KubaTaba1uga/open_source_ebook_reader/README.md

# open_source_ebook_reader
Open source ebook reader device.
