KubaTaba1uga/open_source_ebook_reader/docs/hardware.md

Hardware
===========

The ebook reader is composed of:
- [Display](hardware/display.md)
- [Buttons](hardware/buttons.md)
