KubaTaba1uga/open_source_ebook_reader/package/ebook_reader/data/poweroff_screen.png

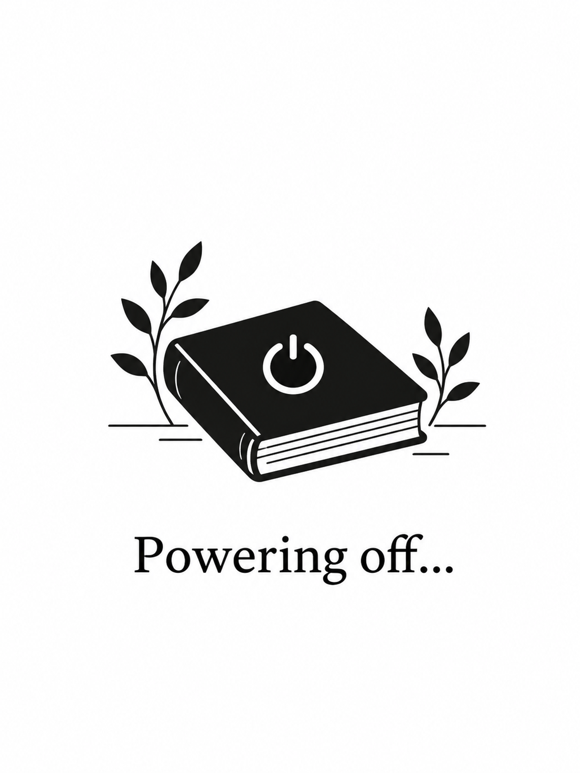
package/ebook_reader/data/poweroff_screen.png
