KubaTaba1uga/open_source_ebook_reader/kicad/rpi_hat/rpi_hat/rpi_hat.kicad_pcb

## KiCad design kicad/rpi_hat/rpi_hat/rpi_hat.kicad_pcb (2026-10-03)

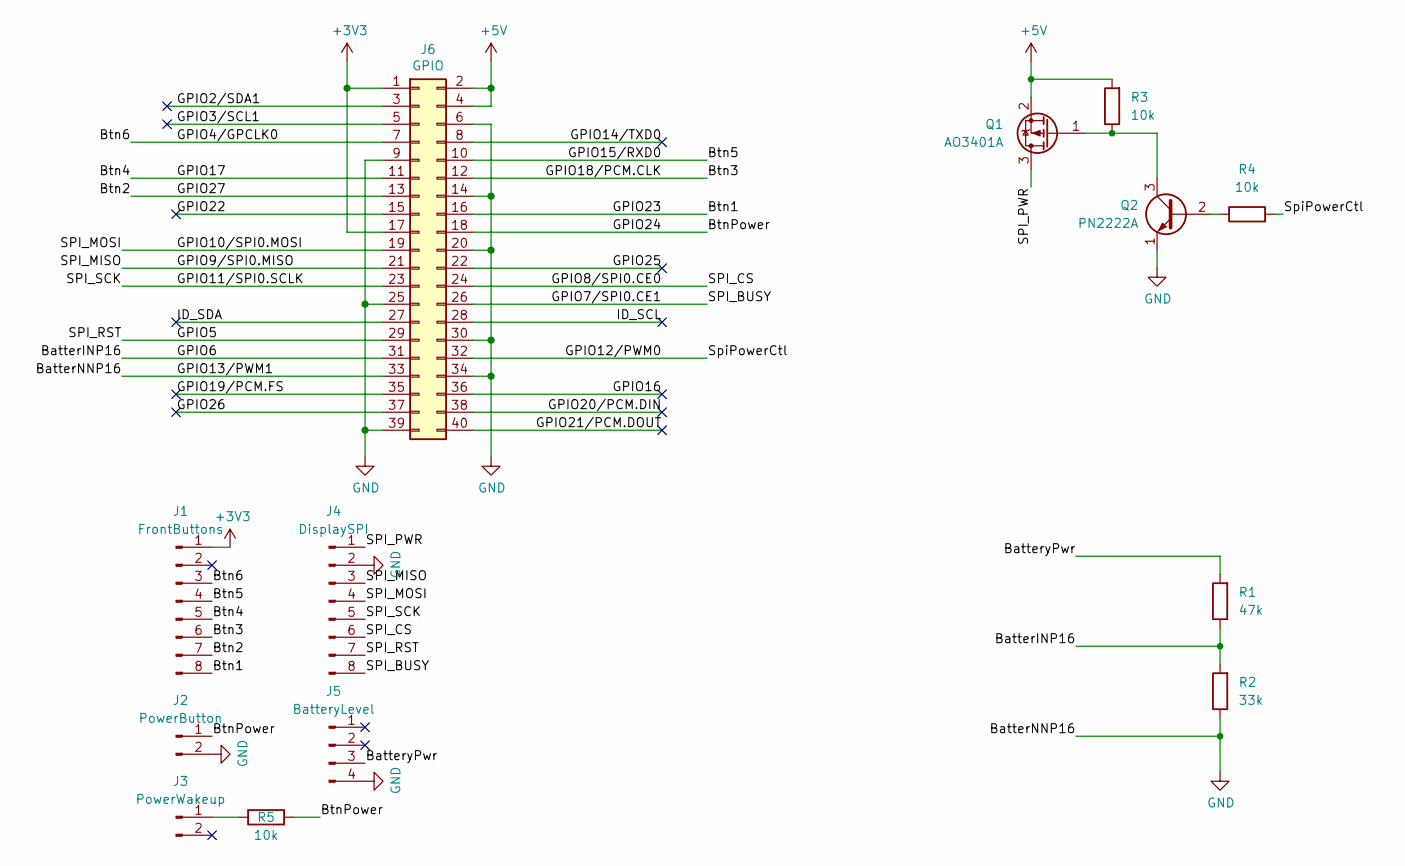
[picture p2: schematic rpi_hat.kicad_sch]

Parts:
J1: FrontButtons; JST_XH_S8B-XH-A_1x08_P2.50mm_Horizontal
J2: PowerButton; JST_XH_S2B-XH-A_1x02_P2.50mm_Horizontal
J3: PowerWakeup; JST_XH_S2B-XH-A_1x02_P2.50mm_Horizontal
J4: DisplaySPI; JST_PH_S8B-PH-K_1x08_P2.00mm_Horizontal
J5: BatteryLevel; JST_XH_S4B-XH-A_1x04_P2.50mm_Horizontal
J6: GPIO; PinSocket_2x20_P2.54mm_Vertical
Q1: AO3401A; SOT-23
Q2: PN2222A; TO-92_Inline
R1: 47k; R_Axial_DIN0207_L6.3mm_D2.5mm_P10.16mm_Horizontal
R2: 33k; R_Axial_DIN0207_L6.3mm_D2.5mm_P10.16mm_Horizontal
R3, R4, R5: 10k; R_Axial_DIN0207_L6.3mm_D2.5mm_P10.16mm_Horizontal

Connections:
+3V3: J1.1, J6.1, J6.17
+5V: J6.2, J6.4, Q1.2 (S), R3.2
/BatterINP16: J6.31, R1.1, R2.2
/BatteryPwr: J5.3, R1.2
/Btn1: J1.8, J6.16
/Btn2: J1.7, J6.13
/Btn3: J1.6, J6.12
/Btn4: J1.5, J6.11
/Btn5: J1.4, J6.10
/Btn6: J1.3, J6.7
/BtnPower: J2.1, J6.18, R5.2
/GPIO2/SDA1: J6.3
/GPIO3/SCL1: J6.5
/GPIO5: J4.7, J6.29
/GPIO7/SPI0.CE1: J4.8, J6.26
/GPIO8/SPI0.CE0: J4.6, J6.24
/GPIO9/SPI0.MISO: J4.3, J6.21
/GPIO10/SPI0.MOSI: J4.4, J6.19
/GPIO11/SPI0.SCLK: J4.5, J6.23
/GPIO12/PWM0: J6.32, R4.2
/GPIO14/TXD0: J6.8
/GPIO16: J6.36
/GPIO19/PCM.FS: J6.35
/GPIO20/PCM.DIN: J6.38
/GPIO21/PCM.DOUT: J6.40
/GPIO22: J6.15
/GPIO25: J6.22
/GPIO26: J6.37
/ID_SCL: J6.28
/ID_SDA: J6.27
/SPI_PWR: J4.1, Q1.3 (D)
GND: J2.2, J4.2, J5.4, J6.6, J6.9, J6.14, J6.20, J6.25, J6.30, J6.33, J6.34, J6.39, Q2.1 (E), R2.1
unnamed: J3.1 (Pin_1_1), R5.1
unnamed: Q1.1 (G), Q2.3 (C), R3.1
unnamed: Q2.2 (B), R4.1

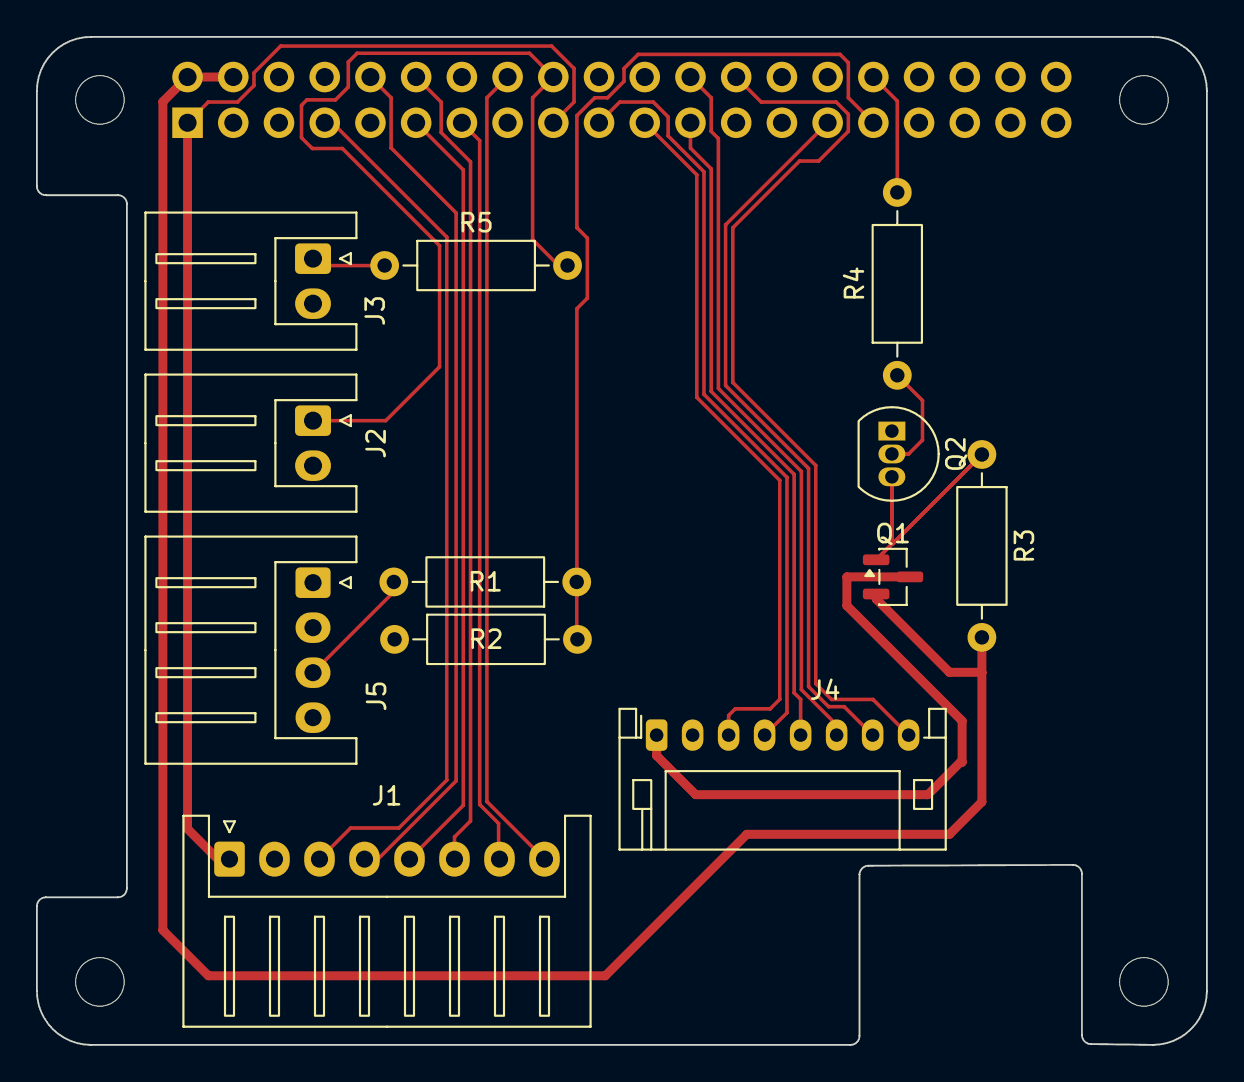
[picture p3: board rpi_hat.kicad_pcb from above]

Board: 2 copper layers, 65.0 x 56.0 mm, 17 parts (1 on the bottom side), 23 nets.

Other parts of the board:
MH1, MH2, MH3, MH4: MountingHole_2.7mm_M2.5
