KubaTaba1uga/open_source_ebook_reader/kicad/buttons/buttons.kicad_pcb

## KiCad design kicad/buttons/buttons.kicad_pcb (2026-09-03)

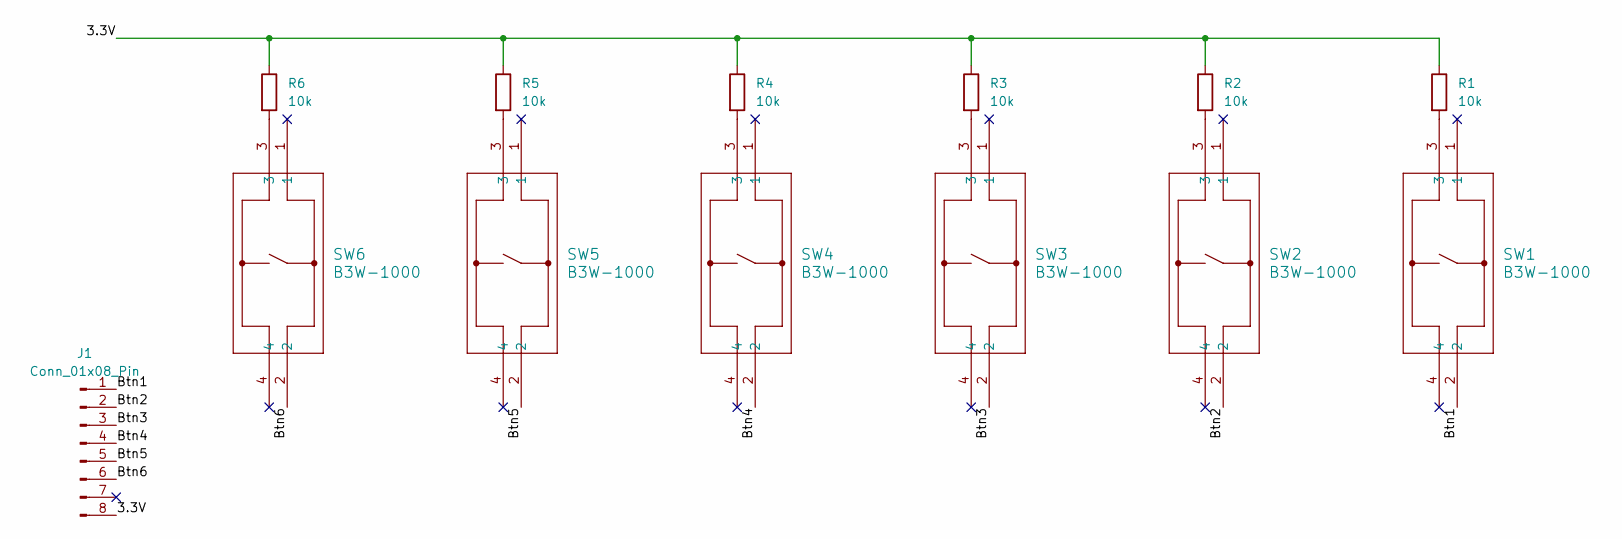
[picture p4: schematic buttons.kicad_sch]

Parts:
J1: Conn_01x08_Pin; JST_XH_S8B-XH-A_1x08_P2.50mm_Horizontal
R1, R2, R3, R4, R5, R6: 10k; R_Axial_DIN0207_L6.3mm_D2.5mm_P10.16mm_Horizontal
SW1, SW2, SW3, SW4, SW5, SW6: B3W-1000; SW_B3W-1000_OMR

Connections:
/3.3V: J1.8, R1.1, R2.1, R3.1, R4.1, R5.1, R6.1
/Btn1: J1.1, SW1.2
/Btn2: J1.2, SW2.2
/Btn3: J1.3, SW3.2
/Btn4: J1.4, SW4.2
/Btn5: J1.5, SW5.2
/Btn6: J1.6, SW6.2
unnamed: R1.2, SW1.3
unnamed: R2.2, SW2.3
unnamed: R3.2, SW3.3
unnamed: R4.2, SW4.3
unnamed: R5.2, SW5.3
unnamed: R6.2, SW6.3

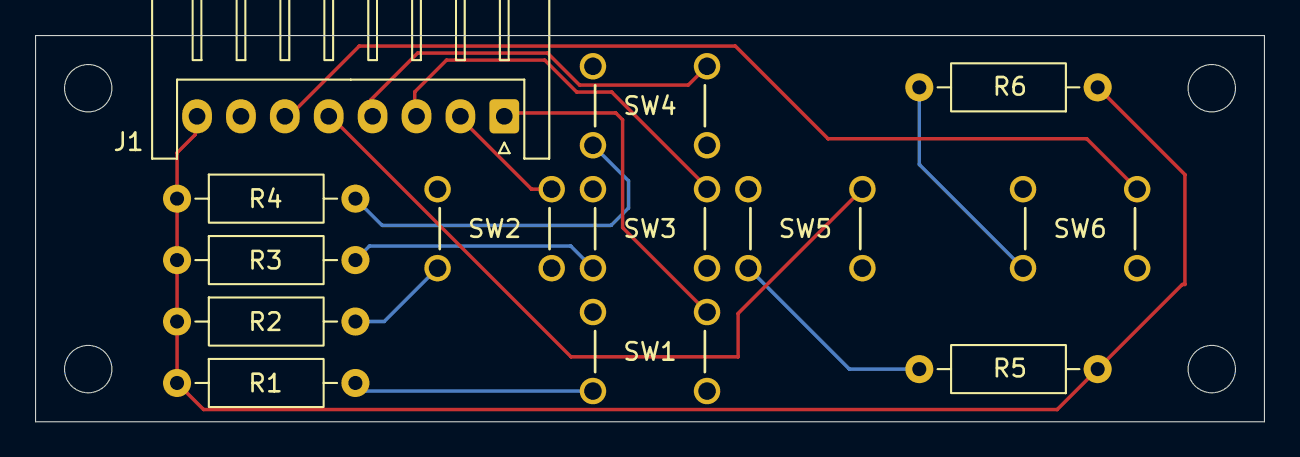
[picture p5: board buttons.kicad_pcb from above]

Board: 2 copper layers, 70.0 x 22.0 mm, 17 parts (0 on the bottom side), 13 nets.

Other parts of the board:
MH2, MH2#2, MH2#3, MH2#4: MountingHole_2.7mm_M2.5
