KubaTaba1uga/open_source_ebook_reader/(commit log)

2026-05-16 Add support for stm32mp135d odyssey (#3)
    [genimage.cfg, genimage_debug.cfg]
2026-05-18 Add ebook reader app (#4)
    * improve docs
    * add ebook reader app
    * install libgpiod 1.6.5
    * add gdb support
    * add gdb and openocd support to odyssey board
    * add cross compile script for ebook reader
    * bannerize src code
2026-09-03 Add enclosure (#5)
    * start hat in kicad
    * addd pcb layer to hat
    * add footprints to hat
    * start buttons board
    * finish buttons board
    * improve buttons board
    * add adc1 channel 2
    * add ADC for battery measurement
    * connect adc to battery
    * fix hat bugs
    * fix buttons gpio mapping
    * fix adc bug
    * add power switch to it8951
    * improve daemonize
    [buttons.kicad_pcb, buttons.kicad_sch, power_on_button.kicad_pcb, power_on_button.kicad_sch, rpi_hat.kicad_pcb, rpi_hat.kicad_sch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]
2026-09-09 Add support for it8951 (#6)
    * add power switch ctrl to it8951
    * add test script for screen
2026-09-12 Add support for front buttons (#7)
    * add buttons test script
    [rpi_hat.kicad_pcb]
2026-10-03 Add support for power on button (#8)
    * add power button
    * fix bug in power on button routing in hat
    * update test_buttons.py script
    * implement power off buttton in all fsm
    * refactor display subsystem
    [power_on_button.kicad_pcb, power_on_button.kicad_sch, rpi_hat.kicad_pcb, rpi_hat.kicad_sch]
2026-10-20 Add support for battery (#10)
    * add program to read voltage from adc and fix hat
    * add battery support in lvgl
